Doccrazy/oil-meter/(commit log)

2026-10-30 add android calibration app
2026-11-01 switch to firebeetle 2
2026-11-01 add 3D printable case (OpenSCAD)
    FireBeetle 2 on the floor with push-rods for RST/BOOT, battery in a frame
    under the lid, JSN-SR04T board upright on the side wall with the probe
    socket accessible from outside.
    [oil_meter_case.scad]
2026-11-01 move sensor connector to case top
    [oil_meter_case.scad]
